alanmonu12/roof-controller/step/PFF15-3-10W.stp

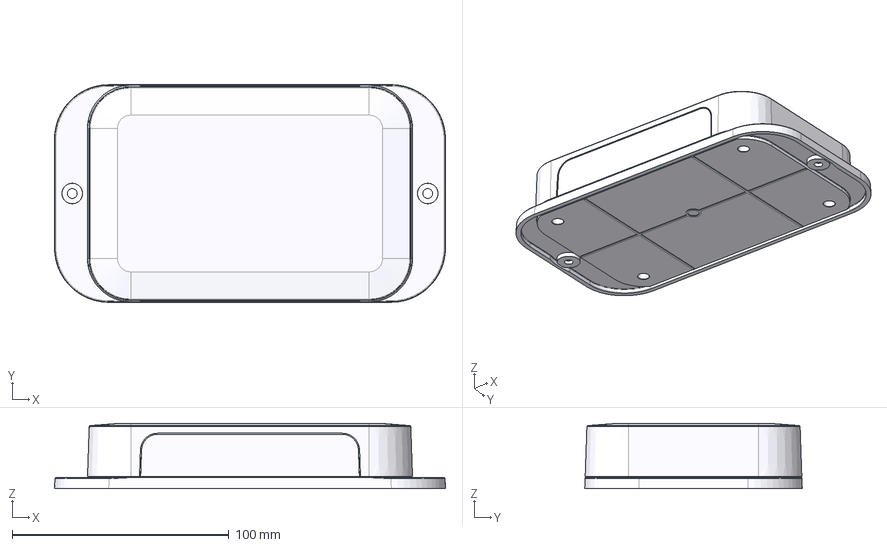
[picture p1: CAD file, 2025-06-09]
step/PFF15-3-10W.stp
180.4 x 100.4 x 30.0 mm
PFF15-10
PFC15-3-10
PFP15-3
PFP15-3_MIR
Cross Recessed Pan Head Tapping Screw - Type F - Type I - Metric M2.5x0.45 x 8 x 4
