alanmonu12/roof-controller/step/WE-LQSH-4020_rev1.stp

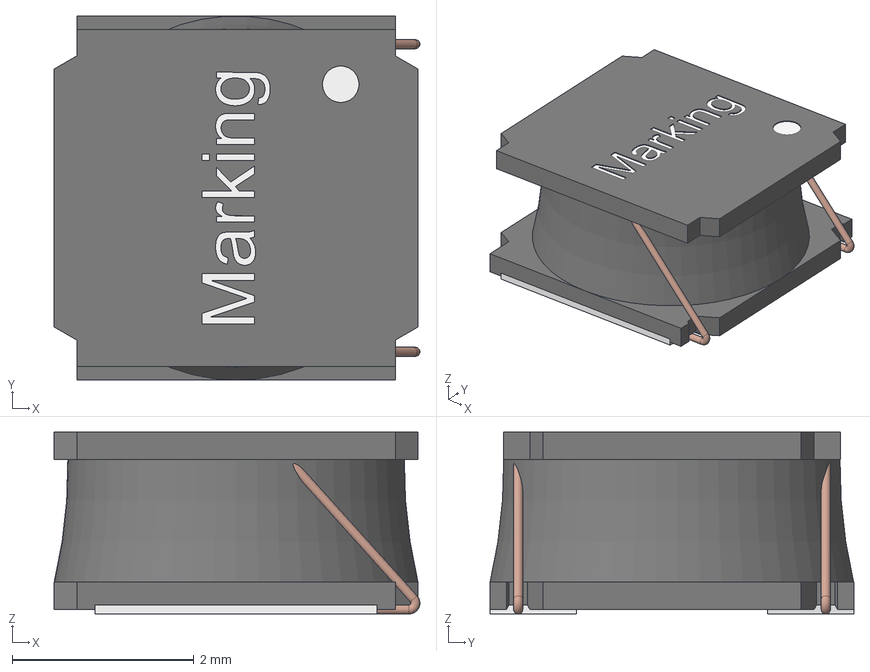
[picture p2: CAD file, 2025-06-09]
step/WE-LQSH-4020_rev1.stp
4.02 x 4.00 x 2.00 mm
housing
contact x 2
Glue
Wire x 2
