alanmonu12/roof-controller/step/DBV0006A.stp

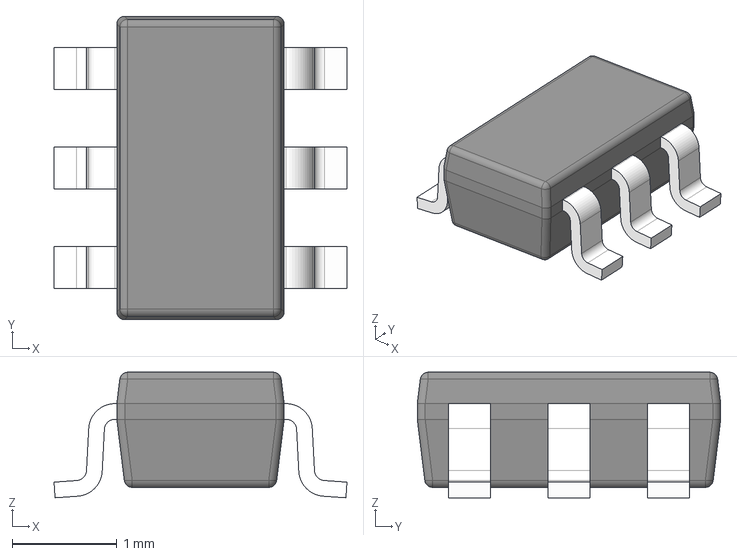
[picture p3: CAD file, 2025-06-09]
step/DBV0006A.stp
2.80 x 2.90 x 1.20 mm
BODY-SOT
LEAD-SOT x 6
