alanmonu12/roof-controller/Tarjeta-WiFi-control-techo.kicad_pcb

## KiCad design Tarjeta-WiFi-control-techo.kicad_pcb (2025-07-18)

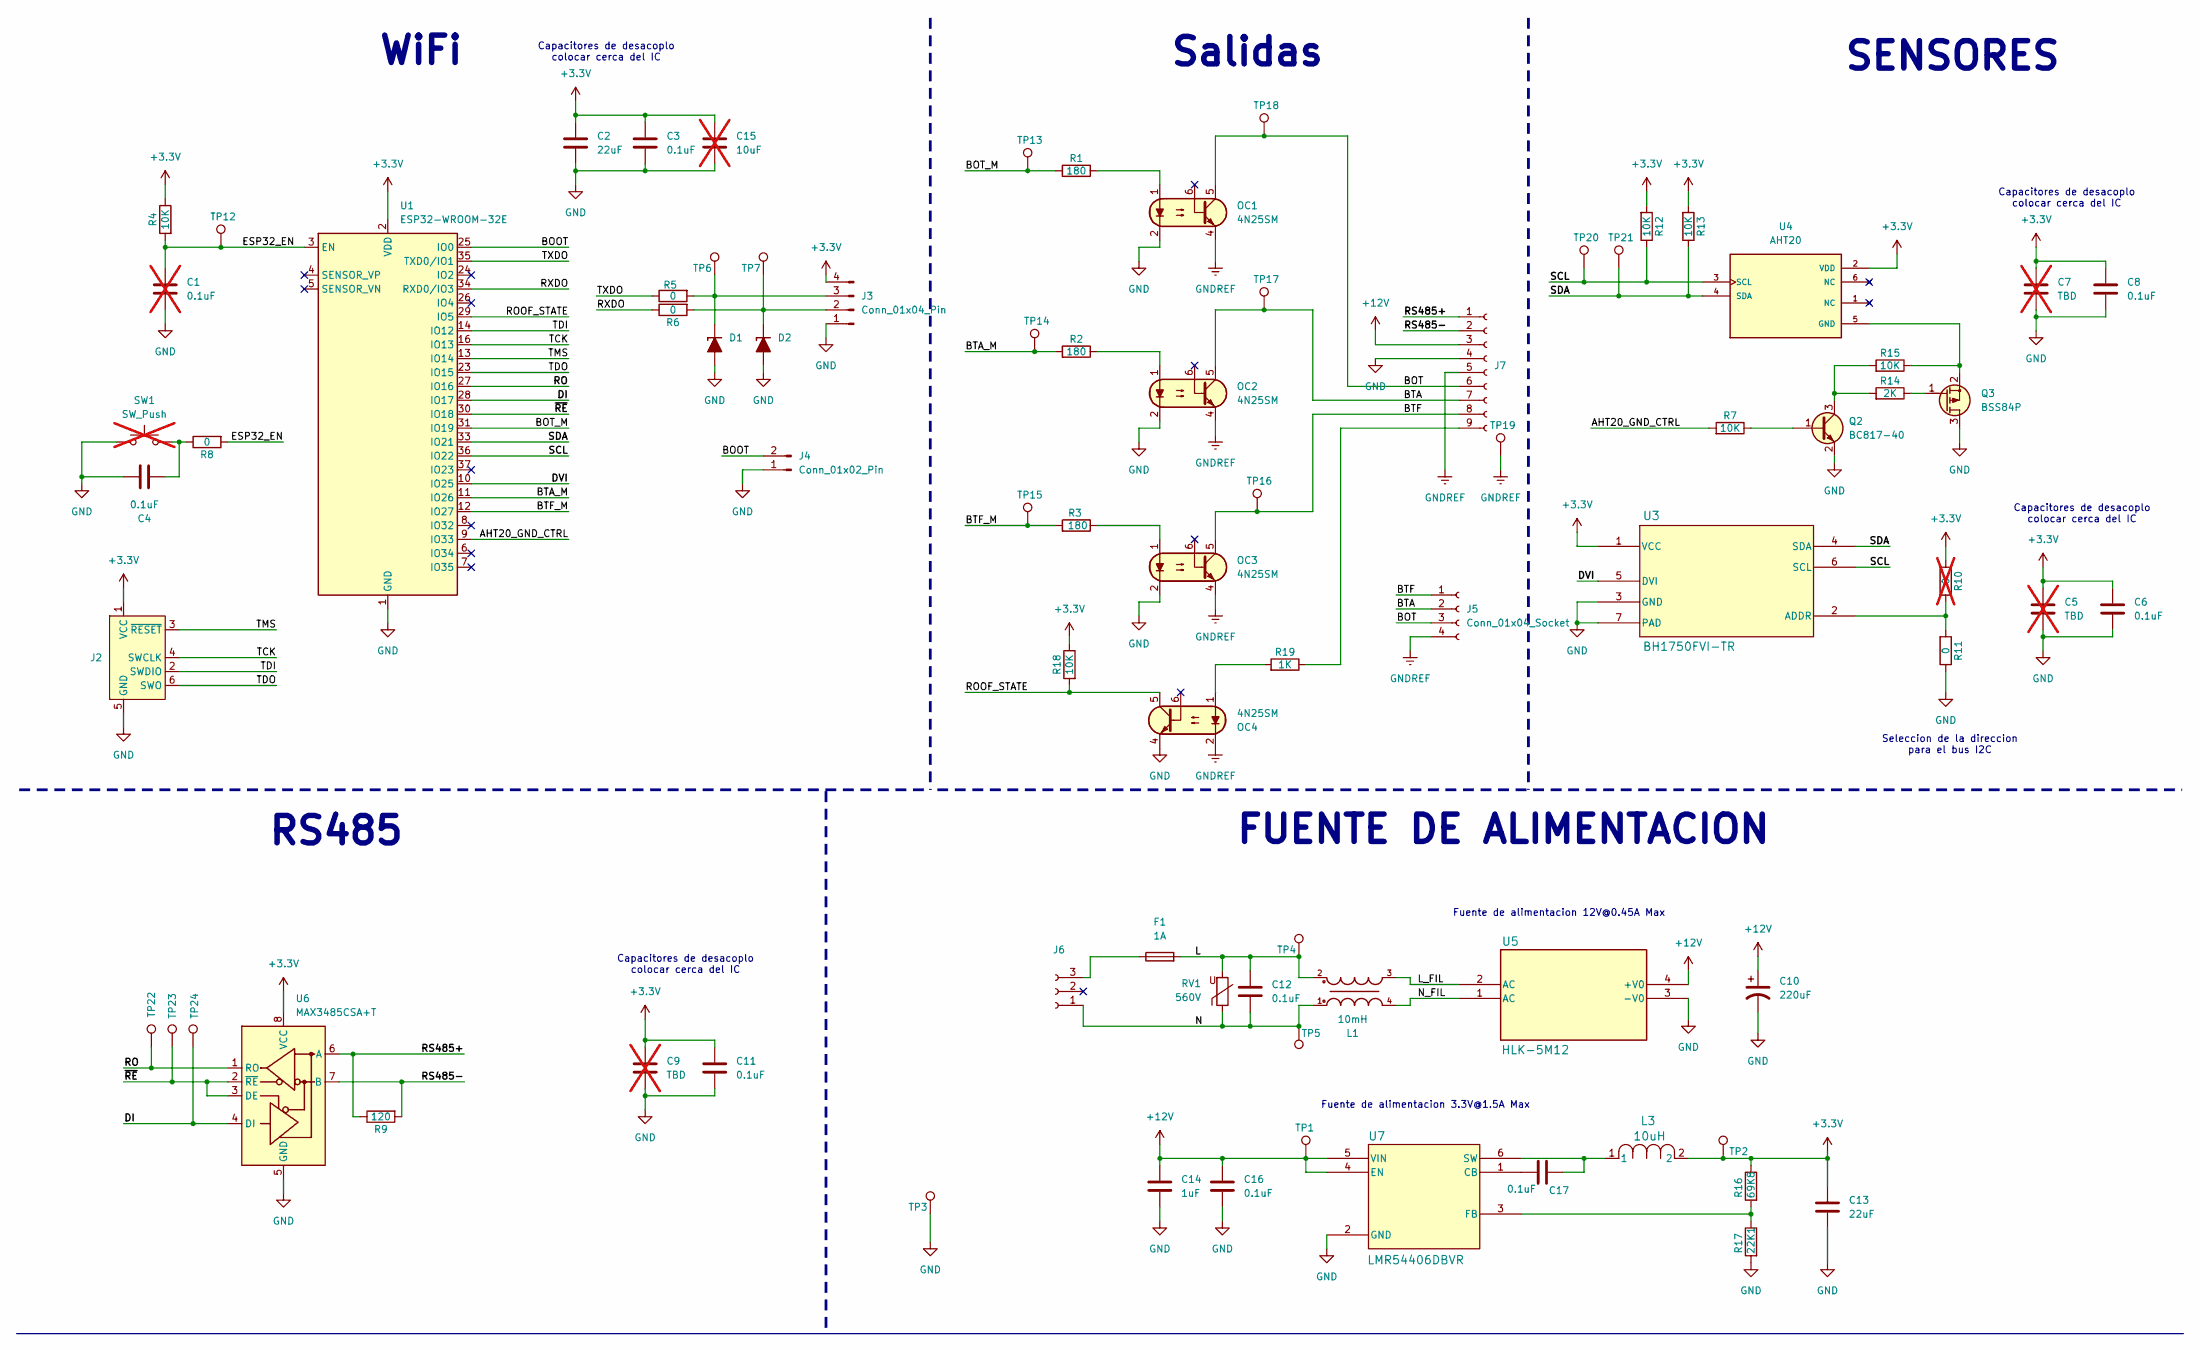
[picture p4: schematic Tarjeta-WiFi-control-techo.kicad_sch, Esquematico]

Parts:
C1: 0.1uF; C_0805_2012Metric; not fitted
C2, C13: 22uF; C_0805_2012Metric; MPN GRM21BZ71A226ME15L
C3, C4, C6, C8, C11, C16, C17: 0.1uF; C_0805_2012Metric; MPN GCD21BR71H104KA01L
C5, C7, C9: TBD; C_0805_2012Metric; not fitted
C10: 220uF; CP_Elec_5x3; MPN EEH-ZL1E221XV
C12: 0.1uF; C_Disc_D5.0mm_W2.5mm_P5.00mm; MPN GCD21BR71H104KA01L
C14: 1uF; C_0805_2012Metric; MPN GCM21BR71H105KA03L
C15: 10uF; C_0805_2012Metric; not fitted
D1, D2: PTVS5V0S1UTR; D_SOD-123F; MPN PTVS5V0S1UTR,115
F1: 1A; Fuseholder_Cylinder-5x20mm_Schurter_0031_8201_Horizontal_Op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; MPN 0031.8211
J2: Conn_ARM_SWD_TagConnect_TC2030-NL; Tag-Connect_TC2030-IDC-NL_2x03_P1.27mm_Vertical
J3: Conn_01x04_Pin; PinHeader_1x04_P2.54mm_Vertical
J4: Conn_01x02_Pin; PinHeader_1x02_P2.54mm_Vertical
J5: Conn_01x04_Socket; PhoenixContact_MC_1,5_4-G-3.81_1x04_P3.81mm_Horizontal; MPN 1803293
J6: Conn_01x03_Socket; PhoenixContact_MC_1,5_3-G-3.81_1x03_P3.81mm_Horizontal; MPN 1803280
J7: Conn_01x09_Socket; PhoenixContact_MC_1,5_9-G-3.81_1x09_P3.81mm_Horizontal; MPN 1803345
L1: 10mH; WE-CMB_XS; MPN 744821110
L3: 10uH; IND_05042100_WRE; MPN 74405042100
OC1, OC2, OC3, OC4: 4N25SM; SMDIP-6_W9.53mm; MPN 4N25SM
Q2: BC817-40; SOT-23; MPN BC817-40W,115
Q3: BSS84P; SOT-23; MPN BSS84PH6327XTSA2
R1, R2, R3: 180; R_0805_2012Metric; MPN RNCP0805FTD180R
R4, R7, R12, R13, R15, R18: 10K; R_0805_2012Metric; MPN RNCP0805FTD10K0
R5, R6, R8, R11: 0; R_0805_2012Metric; MPN RMCF0805ZT0R00
R9: 120; R_0805_2012Metric; MPN RNCF0805BTE120R
R10: 0; R_0805_2012Metric; not fitted
R14: 2K; R_0805_2012Metric; MPN RPC0805JT2K00
R16: 69K8; R_0805_2012Metric; MPN RK73H2ATTD6982F
R17: 22K1; R_0805_2012Metric; MPN RK73H2ATTD2212F
R19: 1K; R_0805_2012Metric; MPN RPC0805JT1K00
RV1: 560V; RV_Disc_D7mm_W3.4mm_P5mm; MPN MOV-10D561K
SW1: SW_Push; SW_Push_SPST_NO_Alps_SKRK; not fitted
TP1, TP2, TP3, TP4, TP5, TP6, TP7, TP12, TP13, TP14, TP15, TP16, TP17, TP18, TP19, TP20, TP21, TP22, TP23, TP24: TestPoint; TestPoint_Pad_D1.0mm
U1: ESP32-WROOM-32E; ESP32-WROOM-32D; MPN ESP32-WROOM-32E-H4
U3: BH1750FVI-TR; BH1750FVI-TR_ROM-M; MPN BH1750FVI-TR
U4: AHT20; PSON100P300X300X110-6N; PARTREV V1.0
U5: HLK-5M12; HLK-5Mxx_HLK; MPN HLK-5M12
U6: MAX3485CSA+T; SOIC-8_3.9x4.9mm_P1.27mm; MPN MAX3485CSA+T
U7: LMR54406DBVR; LMR54406DBVR_TEX; MPN LMR54406DBVR

Connections:
+3.3V: C2.1, C3.1, C5.1, C6.1, C7.1, C8.1, C9.1, C11.1, C13.1, C15.1, J2.1 (VCC), J3.4, L3.2, R4.2, R10.1, R12.1, R13.1, R16.2, R18.2, TP2.1, U1.2 (VDD), U3.1 (VCC), U4.2 (VDD), U6.8 (VCC)
+12V: C10.1, C14.1, C16.1, J7.3, TP1.1, U5.4 (+V0), U7.4 (EN), U7.5 (VIN)
/AHT20_GND_CTRL: R7.1, U1.9 (IO33)
/BOOT: J4.2, U1.25 (IO0)
/BOT: J5.3, J7.6, OC1.5, TP18.1
/BOT_M: R1.1, TP13.1, U1.31 (IO19)
/BTA: J5.2, J7.7, OC2.5, TP17.1
/BTA_M: R2.1, TP14.1, U1.11 (IO26)
/BTF: J5.1, J7.8, OC3.5, TP16.1
/BTF_M: R3.1, TP15.1, U1.12 (IO27)
/DI: TP24.1, U1.28 (IO17), U6.4 (DI)
/DVI: U1.10 (IO25), U3.5 (DVI)
/ESP32_EN: C1.1, R4.1, R8.1, TP12.1, U1.3 (EN)
/L: C12.1, F1.2, L1.2, RV1.2, TP4.1
/L_FIL: L1.3, U5.2 (AC)
/N: C12.2, J6.1, L1.1, RV1.1, TP5.1
/N_FIL: L1.4, U5.1 (AC)
/RO: TP22.1, U1.27 (IO16), U6.1 (RO)
/ROOF_STATE: OC4.5, R18.1, U1.29 (IO5)
/RS485+: J7.1, R9.2, U6.6 (A)
/RS485-: J7.2, R9.1, U6.7 (B)
/RXDO: R6.2, U1.34 (RXD0/IO3)
/SCL: R12.2, TP20.1, U1.36 (IO22), U3.6 (SCL), U4.3 (SCL)
/SDA: R13.2, TP21.1, U1.33 (IO21), U3.4 (SDA), U4.4 (SDA)
/TCK: J2.4 (SWCLK), U1.16 (IO13)
/TDI: J2.2 (SWDIO), U1.14 (IO12)
/TDO: J2.6 (SWO), U1.23 (IO15)
/TMS: J2.3 (~RESET), U1.13 (IO14)
/TXDO: R5.2, U1.35 (TXD0/IO1)
/~RE: TP23.1, U1.30 (IO18), U6.2 (~RE), U6.3 (DE)
GND: C1.2, C2.2, C3.2, C4.2, C5.2, C6.2, C7.2, C8.2, C9.2, C10.2, C11.2, C13.2, C14.2, C15.2, C16.2, D1.2 (A), D2.2 (A), J2.5 (GND), J3.1, J4.1, J7.4, OC1.2, OC2.2, OC3.2, OC4.4, Q2.2 (E), Q3.3 (D), R11.2, R17.1, SW1.1, TP3.1, U1.1 (GND), U1.15 (GND), U1.38 (GND), U1.39 (GND), U3.3 (GND), U3.7 (PAD), U5.3 (-V0), U6.5 (GND), U7.2 (GND)
GNDREF: J5.4, J7.5, OC1.4, OC2.4, OC3.4, OC4.2, TP19.1
unnamed: C4.1, R8.2, SW1.2
unnamed: D1.1 (K), J3.3, R5.1, TP6.1
unnamed: D2.1 (K), J3.2, R6.1, TP7.1
unnamed: F1.1, J6.3
unnamed: J7.9, R19.2
unnamed: OC1.1, R1.2
unnamed: OC2.1, R2.2
unnamed: OC3.1, R3.2
unnamed: OC4.1, R19.1
unnamed: Q2.1 (B), R7.2
unnamed: Q2.3 (C), R14.1, R15.1
unnamed: Q3.1 (G), R14.2
unnamed: Q3.2 (S), R15.2, U4.5 (GND)
unnamed: R10.2, R11.1, U3.2 (ADDR)
unnamed: C17.1, U7.1 (CB)
unnamed: R16.1, R17.2, U7.3 (FB)
unnamed: C17.2, L3.1, U7.6 (SW)

Notes on the sheet:
Capacitores de desacoplo colocar cerca del IC
FUENTE DE ALIMENTACION
SENSORES
Fuente de alimentacion 12V@0.45A Max
WiFi
Fuente de alimentacion 3.3V@1.5A Max
RS485
Seleccion de la direccion para el bus I2C
Salidas

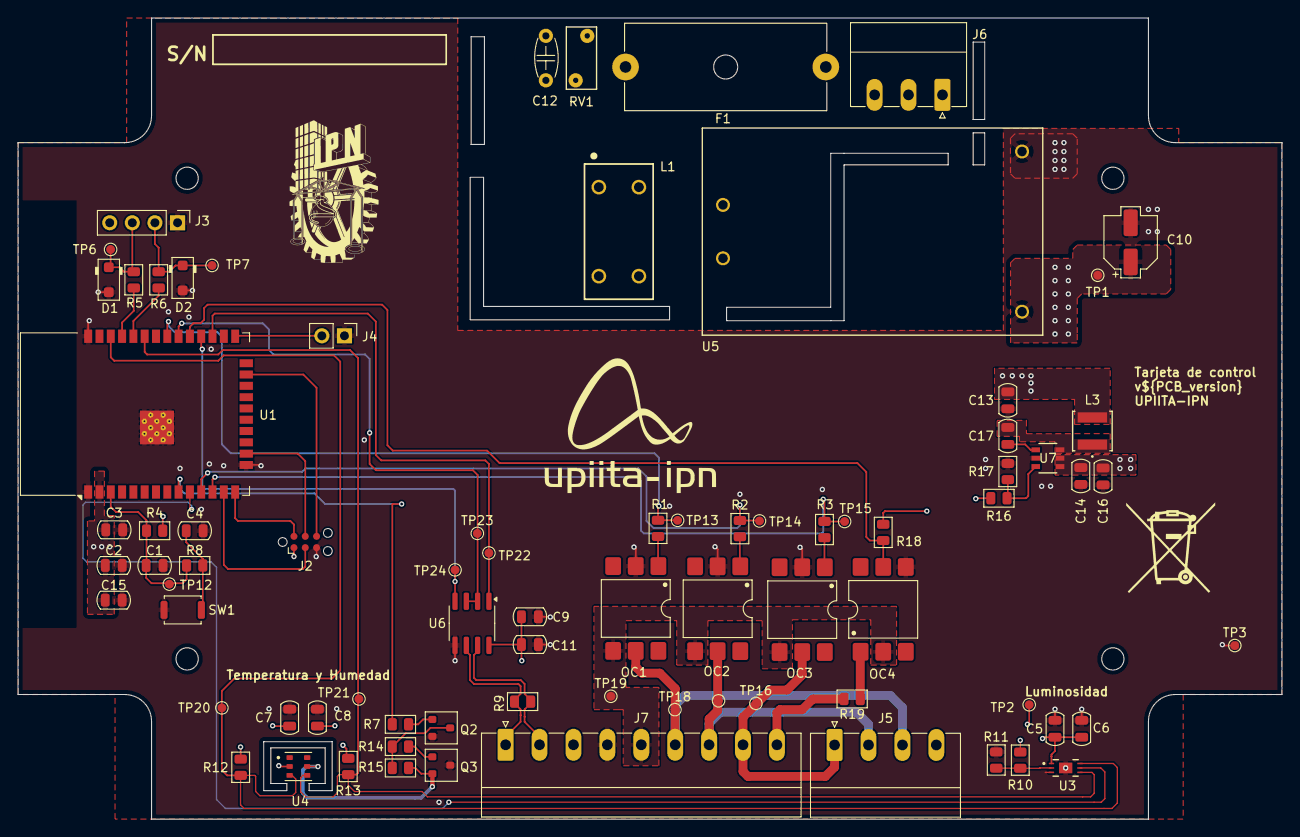
[picture p5: board Tarjeta-WiFi-control-techo.kicad_pcb from above]

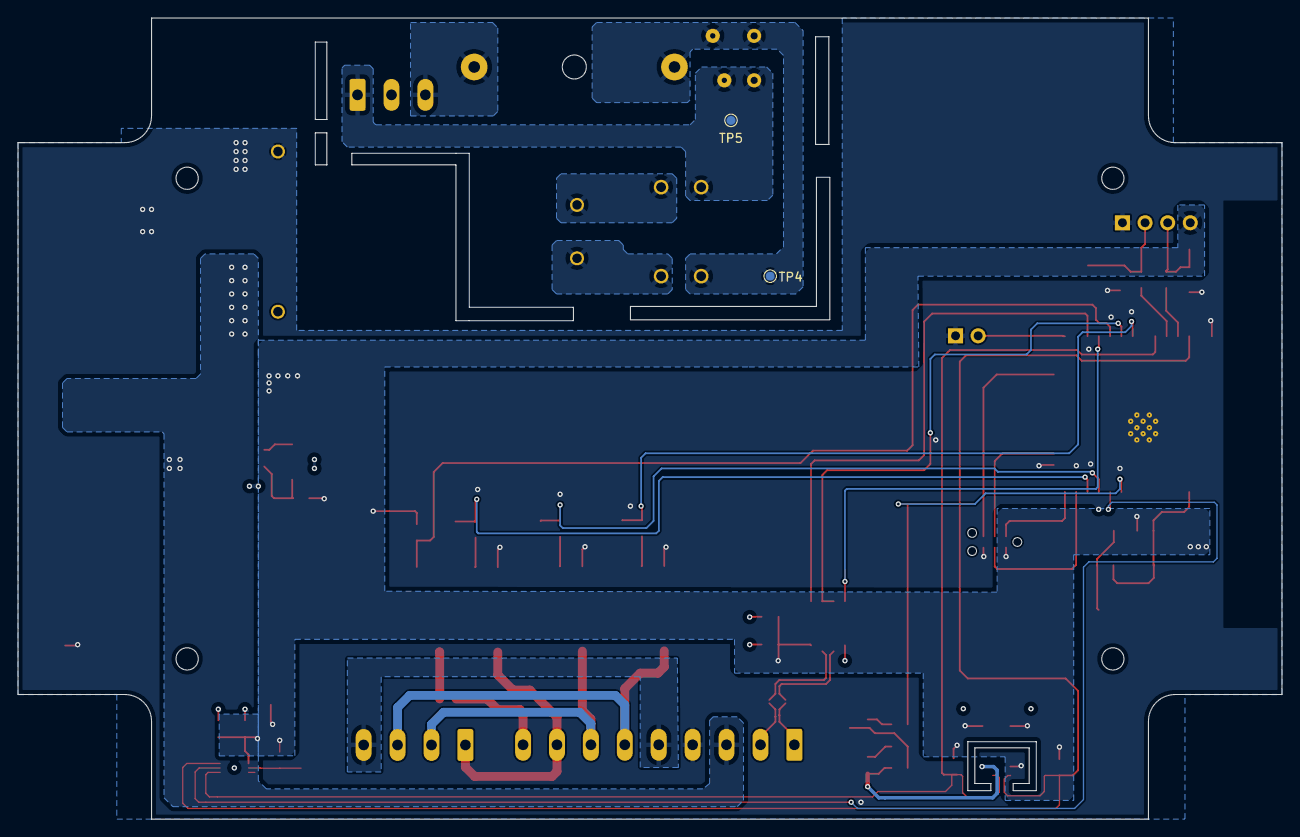
[picture p6: board Tarjeta-WiFi-control-techo.kicad_pcb from below]

Board: 4 copper layers, 142.0 x 90.0 mm, 81 parts (2 on the bottom side), 49 nets.
