alanmonu12/roof-controller/(commit log)

2025-06-11 Se agrego un conector para poder hacer uso del control manual
    [Tarjeta-WiFi-control-techo.kicad_pcb, Tarjeta-WiFi-control-techo.kicad_sch]
2025-07-18 final release
    [Tarjeta-WiFi-control-techo.kicad_pcb, Tarjeta-WiFi-control-techo.kicad_sch]
